aknight000001/Senior-Capstone/Senior Design Project.jpg

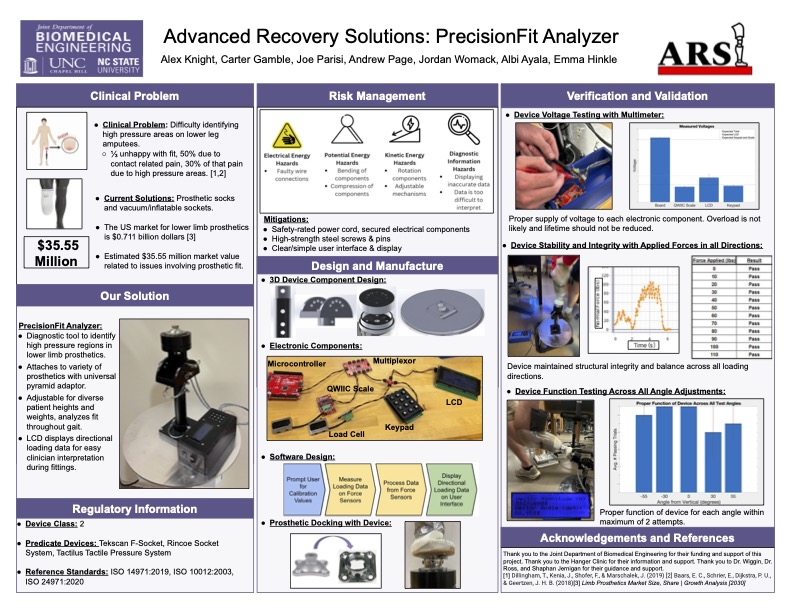
Senior Design Project.jpg
