aknight000001/Senior-Capstone/README.md

# Senior-Capstone
The software and hardware components of my design capstone project for senior year of undergrad.
