aknight000001/Senior-Capstone/Senior Design Project.pdf

Clinical Problem | Risk Management | Verification and Validation
- Clinical Problem: Difficulty identifying high pressure areas on lower leg amputees. ○ ⅓ unhappy with fit, 50% due to contact related pain, 30% of that pain due to high pressure areas. [1,2] ● Current Solutions: Prosthetic socks and vacuum/inflatable sockets. ● The US market for lower limb prosthetics is $0.711 billion dollars [3] $35.55 Million ● Estimated $35.55 million market value related to issues involving prosthetic fit. | ● Safety-rated power cord, secured electrical components ● High-strength steel screws & pins ● Clear/simple user interface & display

# Advanced Recovery Solutions: PrecisionFit Analyzer

Alex Knight, Carter Gamble, Joe Parisi, Andrew Page, Jordan Womack, Albi Ayala, Emma Hinkle

## Design and Manufacture

- 3D

Device

Component

Design:

- Electronic Components:
- Software Design:
- Prosthetic

Docking with

Device:

## Acknowledgements and References

Thank you to the Joint Department of Biomedical Engineering for their funding and support of this project. Thank you to the Hanger Clinic for their information and support. Thank you to Dr. Wiggin, Dr. Ross, and Shaphan Jernigan for their guidance and support.
[1] Dillingham, T., Kenia, J., Shofer, F., & Marschalek, J. (2019) [2] Baars, E. C., Schrier, E., Dijkstra, P. U.,
& Geertzen, J. H. B. (2018)[3] Limb Prosthetics Market Size, Share | Growth Analysis [2030]
- Device Voltage Testing with Multimeter:
- Device Stability and Integrity with Applied Forces in all Directions:
- Device Function Testing Across All Angle Adjustments:

## Our Solution

## Regulatory Information

- Device Class: 2
- Predicate Devices: Tekscan F-Socket, Rincoe Socket System, Tactilus Tactile Pressure System
- Reference

Standards: ISO 14971:2019, ISO 10012:2003, ISO 24971:2020

PrecisionFit Analyzer:
- Diagnostic tool to identify high pressure regions in
lower limb prosthetics.
- Attaches to variety of
prosthetics with universal pyramid adaptor.
- Adjustable for diverse
patient heights and
weights, analyzes fit
throughout gait.
- LCD displays directional loading data for easy
clinician interpretation
during fittings.

Mitigations:

| Multiplexor

QWIIC Scale Load Cell
LCD

Keypad

Microcontroller

Proper supply of voltage to each electronic component. Overload is not likely and lifetime should not be reduced.

Proper function of device for each angle within maximum of 2 attempts.

Device maintained structural integrity and balance across all loading directions.
