aknight000001/Senior-Capstone/drive-download-20250725T043102Z-1-001/Base of Pylon 5.9.pdf

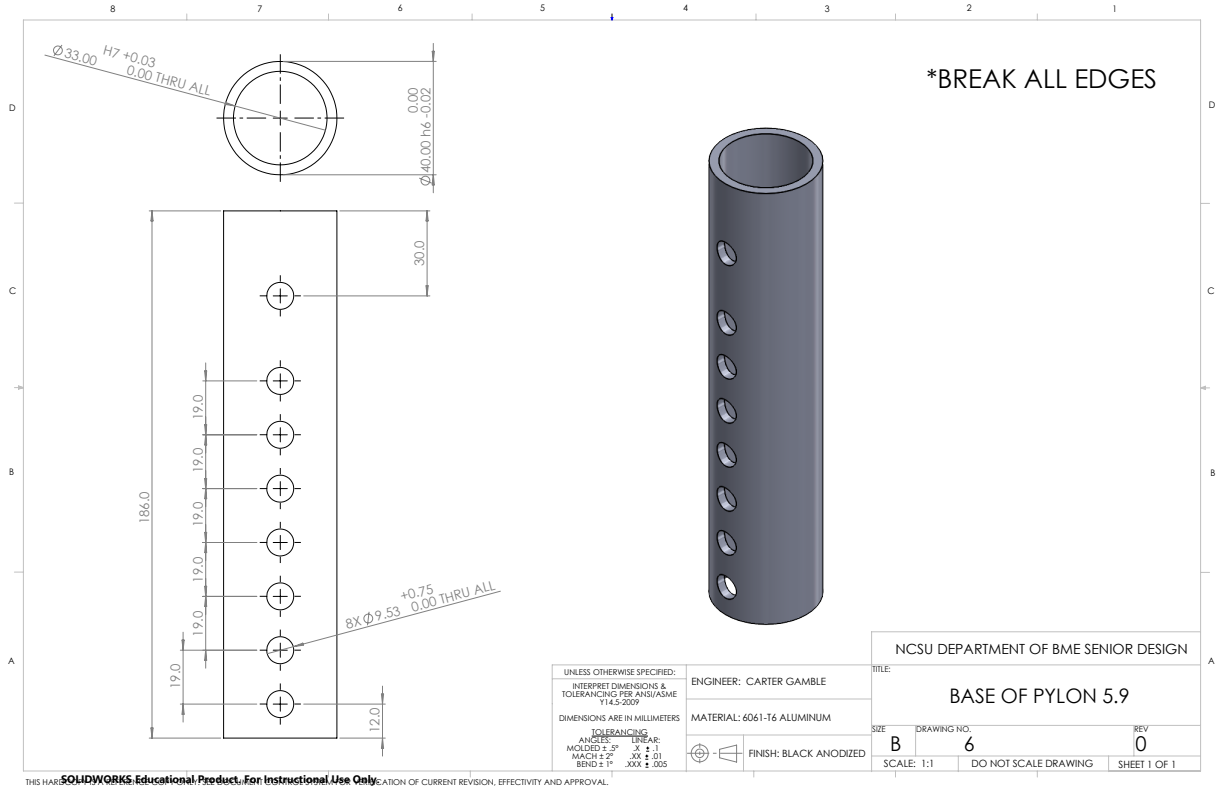
[picture p2: page 1]
0.00 THRU ALL; 33.00 H7 +0.03 0.00 THRU ALL; 6061-T6 ALUMINUM; SHEET 1 OF 1; DRAWING NO.; SCALE: 1:1; .X .1 .XX .01 .XXX .005

*BREAK ALL EDGES

NCSU DEPARTMENT OF BME SENIOR DESIGN
BASE OF PYLON 5.9

UNLESS OTHERWISE SPECIFIED:
ENGINEER: CARTER GAMBLE INTERPRET DIMENSIONS &
TOLERANCING PER ANSI/ASME

DIMENSIONS ARE IN MILLIMETERS
TOLERANCING
ANGLES:
MOLDED ± .5°
MACH ± 2°
BEND ± 1°

FINISH: BLACK ANODIZED

DO NOT SCALE DRAWING

SOLIDWORKS Educational Product. For Instructional Use Only.

THIS HARDCOPY IS A REFERENCE COPY ONLY. SEE DOCUMENT CONTROL SYSTEM FOR VERIFICATION OF CURRENT REVISION, EFFECTIVITY AND APPROVAL.
