aknight000001/Senior-Capstone/drive-download-20250725T043102Z-1-001/Base.pdf

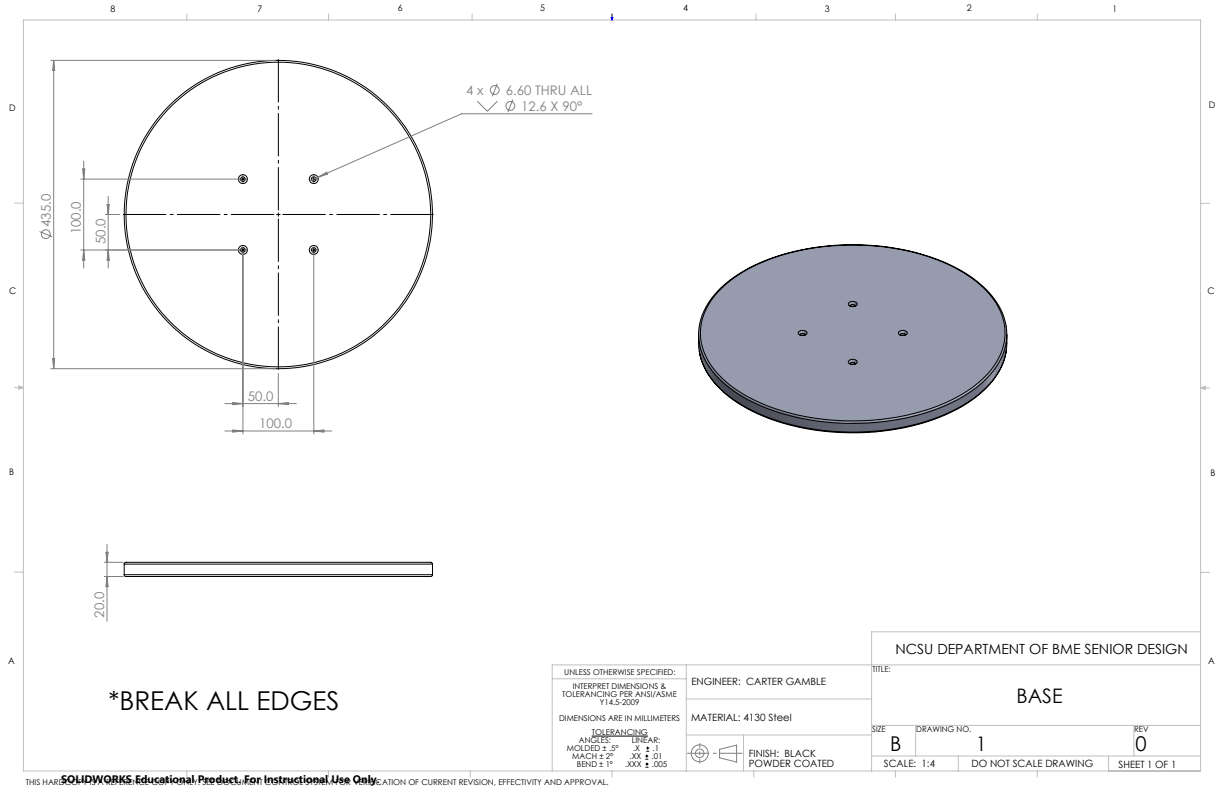
[picture p3: page 1]
6.60 THRU ALL; FINISH: BLACK; POWDER COATED; SHEET 1 OF 1; DRAWING NO.; SCALE: 1:4; .X .1 .XX .01 .XXX .005; MATERIAL: 4130 Steel

NCSU DEPARTMENT OF BME SENIOR DESIGN

*BREAK ALL EDGES

UNLESS OTHERWISE SPECIFIED:
ENGINEER: CARTER GAMBLE INTERPRET DIMENSIONS &
TOLERANCING PER ANSI/ASME

DIMENSIONS ARE IN MILLIMETERS
TOLERANCING
ANGLES:
MOLDED ± .5°
MACH ± 2°
BEND ± 1°

DO NOT SCALE DRAWING

SOLIDWORKS Educational Product. For Instructional Use Only.

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
