aknight000001/Senior-Capstone/drive-download-20250725T043102Z-1-001/Load Cell Housing bottom.pdf

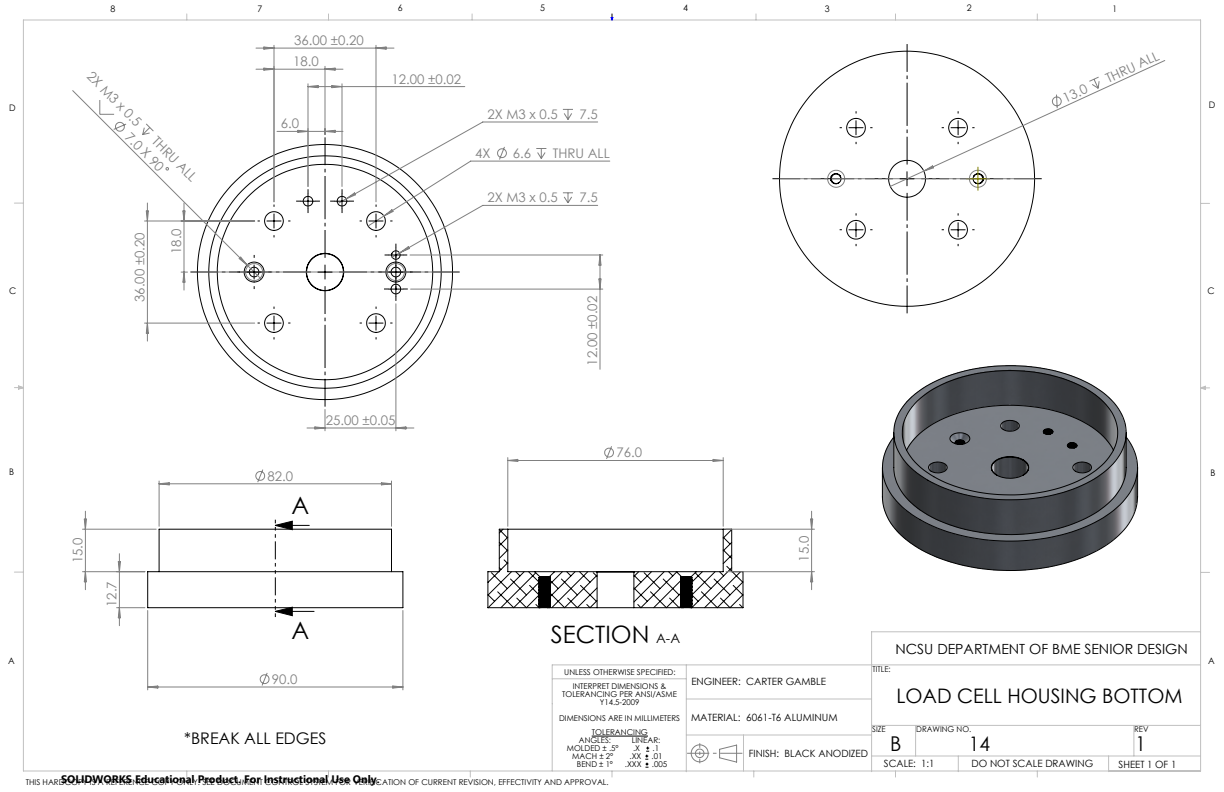
[picture p4: page 1]
6.6 THRU ALL; THRU ALL; 13.0 THRU ALL; SECTION A-A; SHEET 1 OF 1; DRAWING NO.; SCALE: 1:1; .X .1 .XX .01 .XXX .005; MATERIAL: 6061-T6 ALUMINUM

NCSU DEPARTMENT OF BME SENIOR DESIGN
LOAD CELL HOUSING BOTTOM

UNLESS OTHERWISE SPECIFIED:
ENGINEER: CARTER GAMBLE INTERPRET DIMENSIONS &
TOLERANCING PER ANSI/ASME

DIMENSIONS ARE IN MILLIMETERS
TOLERANCING
ANGLES:
MOLDED ± .5°
MACH ± 2°
BEND ± 1°

*BREAK ALL EDGES

FINISH: BLACK ANODIZED

DO NOT SCALE DRAWING

SOLIDWORKS Educational Product. For Instructional Use Only.

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
