aknight000001/Senior-Capstone/drive-download-20250725T043102Z-1-001/Pylon Adapter.pdf

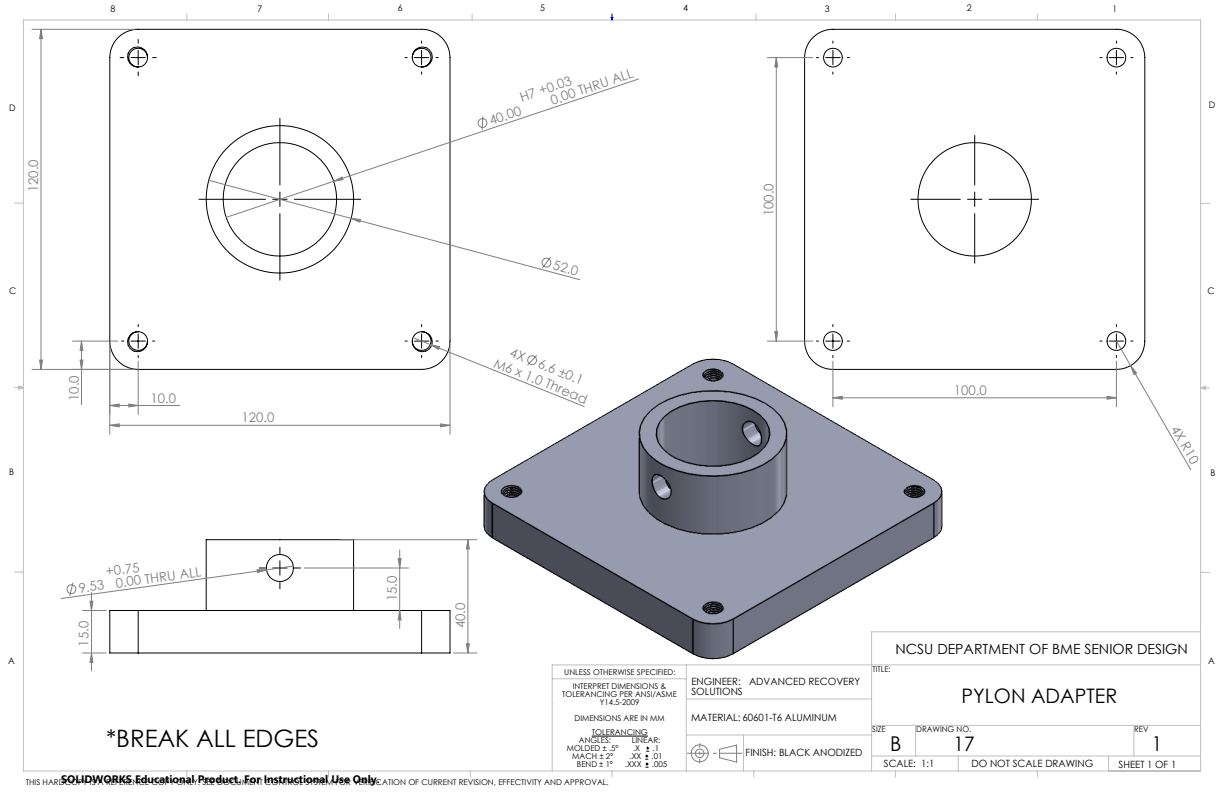
[picture p6: page 1]
M6 x 1.0 Thread 6.6 ±0.1; 0.00 THRU ALL; 60601-T6 ALUMINUM; SHEET 1 OF 1; DRAWING NO.; SCALE: 1:1; DIMENSIONS ARE IN MM; .X .1 .XX .01 .XXX .005; MOLDED ± .5° MACH ± 2° BEND ± 1°

NCSU DEPARTMENT OF BME SENIOR DESIGN
PYLON ADAPTER

UNLESS OTHERWISE SPECIFIED:
SOLUTIONS INTERPRET DIMENSIONS &
TOLERANCING PER ANSI/ASME

ENGINEER: ADVANCED RECOVERY

*BREAK ALL EDGES

FINISH: BLACK ANODIZED

DO NOT SCALE DRAWING

SOLIDWORKS Educational Product. For Instructional Use Only.

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
