aknight000001/Senior-Capstone/drive-download-20250725T043102Z-1-001/Rotation Piece.pdf

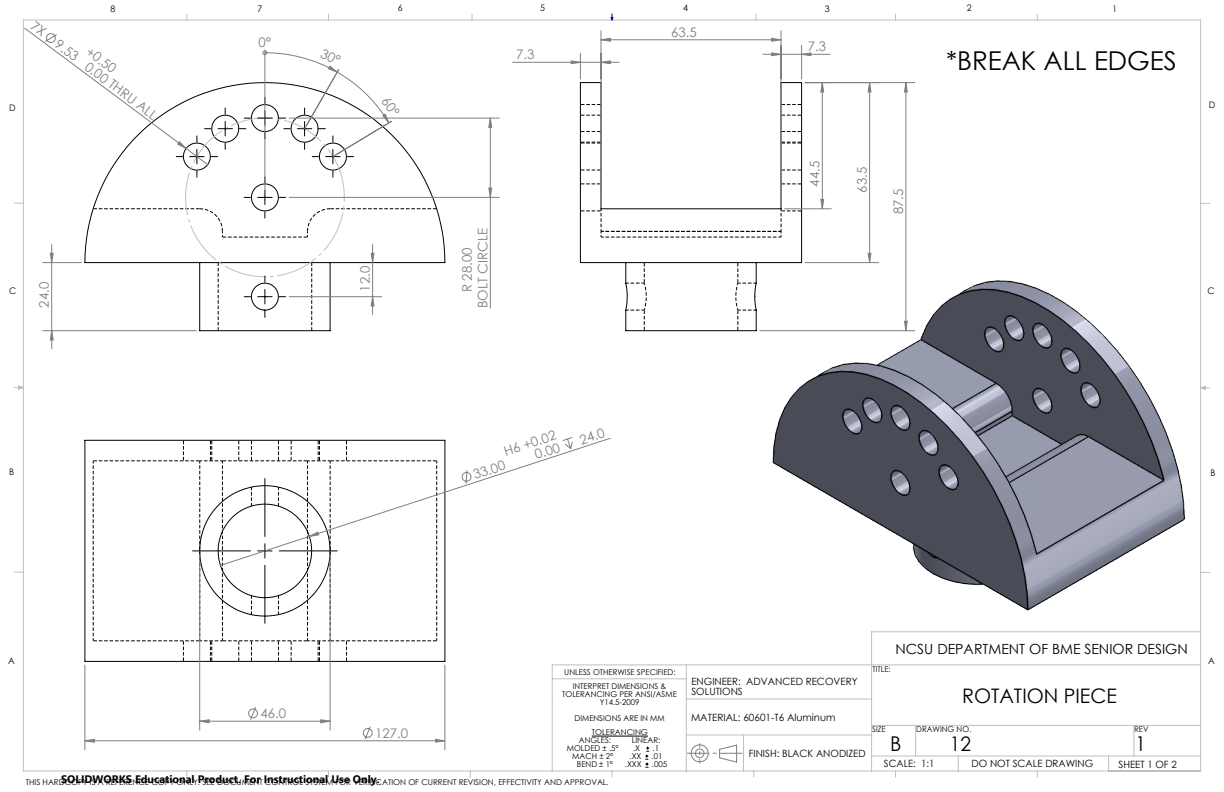
[picture p7: page 1]
9.53 +0.50 0.00 THRU ALL; BOLT CIRCLE; SHEET 1 OF 2; DRAWING NO.; SCALE: 1:1; DIMENSIONS ARE IN MM; .X .1 .XX .01 .XXX .005; MATERIAL: 60601-T6 Aluminum; MOLDED ± .5° MACH ± 2° BEND ± 1°

*BREAK ALL EDGES

NCSU DEPARTMENT OF BME SENIOR DESIGN
ROTATION PIECE

UNLESS OTHERWISE SPECIFIED:
SOLUTIONS INTERPRET DIMENSIONS &
TOLERANCING PER ANSI/ASME

ENGINEER: ADVANCED RECOVERY

FINISH: BLACK ANODIZED

DO NOT SCALE DRAWING

SOLIDWORKS Educational Product. For Instructional Use Only.

THIS HARDCOPY IS A REFERENCE COPY ONLY. SEE DOCUMENT CONTROL SYSTEM FOR VERIFICATION OF CURRENT REVISION, EFFECTIVITY AND APPROVAL.

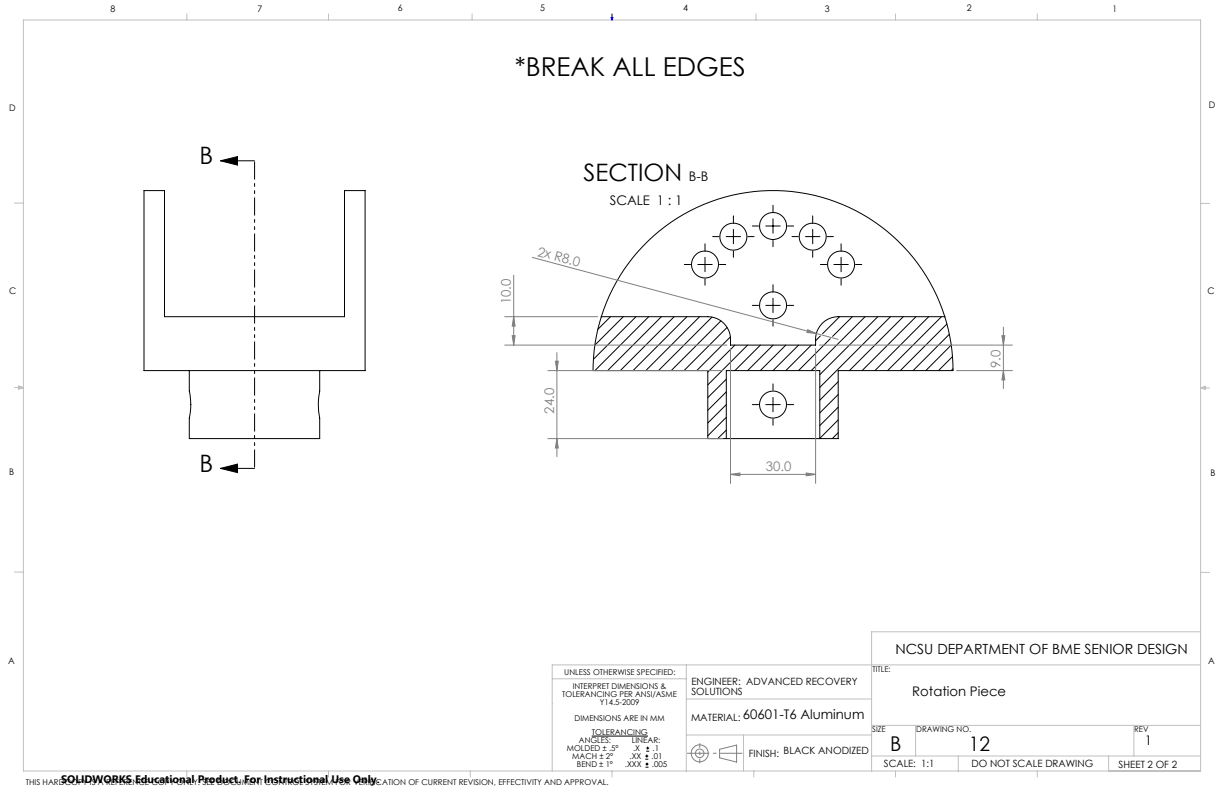
[picture p8: page 2]
SECTION B-B; SCALE 1 : 1; BLACK ANODIZED; Rotation Piece; SHEET 2 OF 2; DRAWING NO.; SCALE: 1:1; DIMENSIONS ARE IN MM; .X .1 .XX .01 .XXX .005; MOLDED ± .5° MACH ± 2° BEND ± 1°

*BREAK ALL EDGES

NCSU DEPARTMENT OF BME SENIOR DESIGN

UNLESS OTHERWISE SPECIFIED:
SOLUTIONS INTERPRET DIMENSIONS &
TOLERANCING PER ANSI/ASME

ENGINEER: ADVANCED RECOVERY
60601-T6 Aluminum

DO NOT SCALE DRAWING

SOLIDWORKS Educational Product. For Instructional Use Only.

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
